amybronk/woordklok/README.md

# woordklok
het is een woordklok
 de dezine files moeten nog geupload worden 
 
