amybronk/woordklok/dezine file/mainprint V1.2/untitled/3d/UA78M33CDCYG3.step

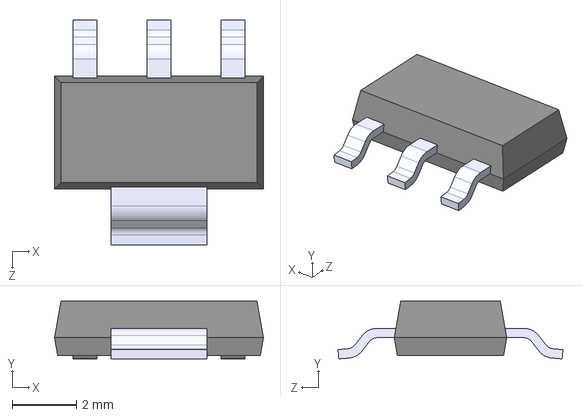
[picture p1: CAD file, 2025-05-20, an earlier design]
dezine file/mainprint V1.2/untitled/3d/UA78M33CDCYG3.step
6.50 x 1.80 x 7.00 mm
