amybronk/woordklok/dezine file/mainprint V1.2/untitled/3d/DS1302Z_.step

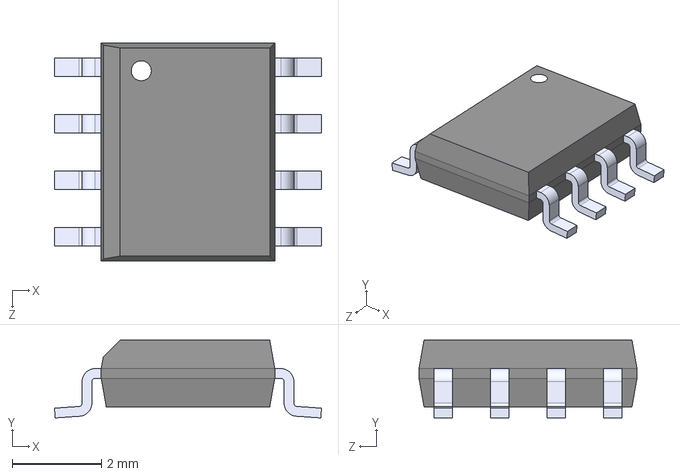
[picture p2: CAD file, 2025-05-20, an earlier design]
dezine file/mainprint V1.2/untitled/3d/DS1302Z_.step
6.00 x 1.75 x 4.90 mm
