amybronk/woordklok/dezine file/mainprint V1.2/untitled/3d/ESP32-S3-WROOM-1-N16R8.step

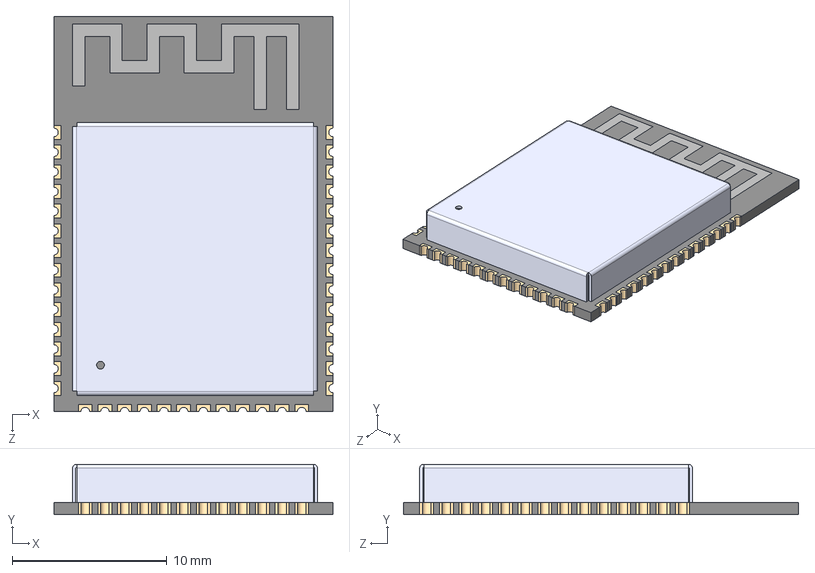
[picture p3: CAD file, 2025-05-20, an earlier design]
dezine file/mainprint V1.2/untitled/3d/ESP32-S3-WROOM-1-N16R8.step
18.0 x 3.25 x 25.5 mm
