amybronk/woordklok/dezine file/mainprint V1.2/untitled/3d/0805res.STEP

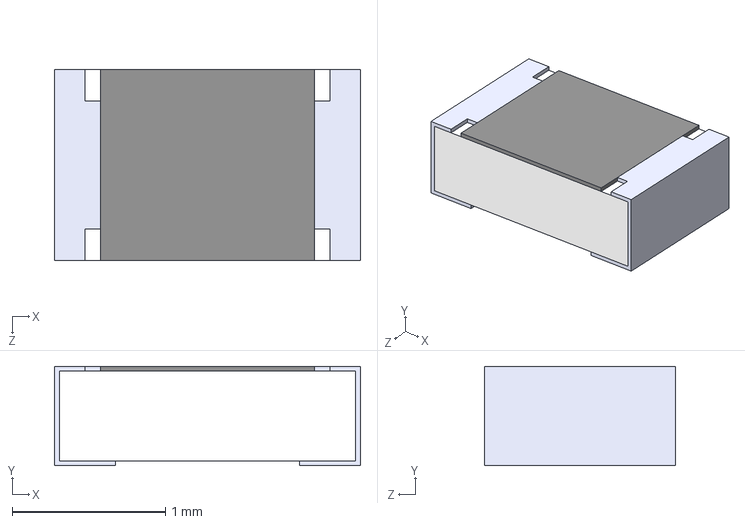
[picture p4: CAD file, 2025-05-20, an earlier design]
dezine file/mainprint V1.2/untitled/3d/0805res.STEP
2.00 x 0.65 x 1.25 mm
