amybronk/woordklok/dezine file/mainprint V1.2/untitled/3d/TS02-66-95-BK-260-LCR-D.step

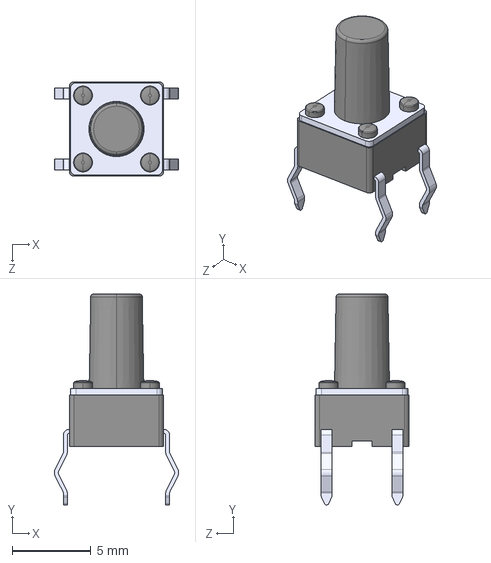
[picture p5: CAD file, 2025-05-20, an earlier design]
dezine file/mainprint V1.2/untitled/3d/TS02-66-95-BK-260-LCR-D.step
7.90 x 13.4 x 6.00 mm
