amybronk/woordklok/dezine file/mainprint V1.2/untitled/3d/CSP-USC16-TR.step

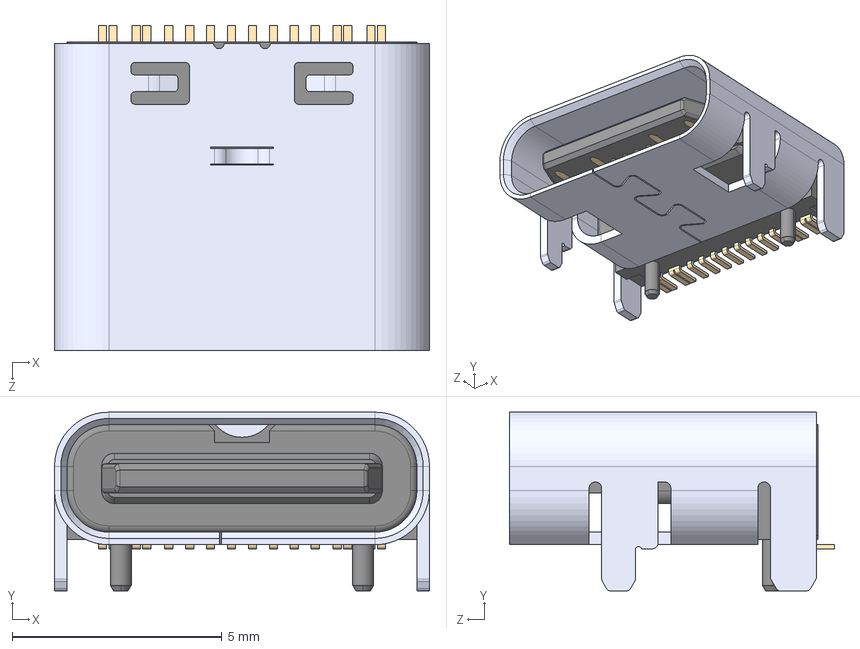
[picture p6: CAD file, 2025-05-20, an earlier design]
dezine file/mainprint V1.2/untitled/3d/CSP-USC16-TR.step
8.94 x 4.26 x 7.75 mm
