amybronk/woordklok/dezine file/mainprint V1.2/untitled/3d/0805cap.STEP

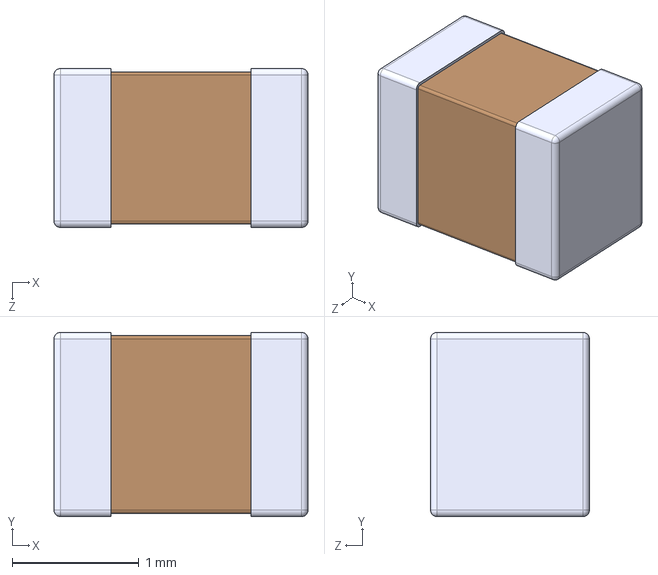
[picture p7: CAD file, 2025-05-20, an earlier design]
dezine file/mainprint V1.2/untitled/3d/0805cap.STEP
2.00 x 1.45 x 1.25 mm
