amybronk/woordklok/dezine file/mainprint V1.2/untitled/3d/WS2812B.step

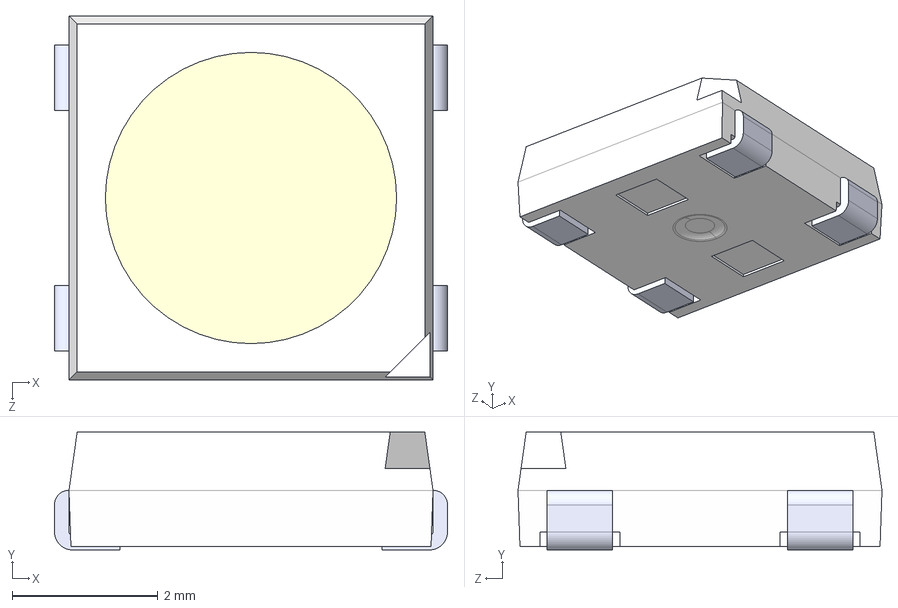
[picture p8: CAD file, 2025-05-20, an earlier design]
dezine file/mainprint V1.2/untitled/3d/WS2812B.step
5.40 x 1.62 x 5.00 mm
