amybronk/woordklok/dezine file/mainprint V1.2/untitled/3d/BHSD-2032-SM--3DModel-STEP-269445.STEP

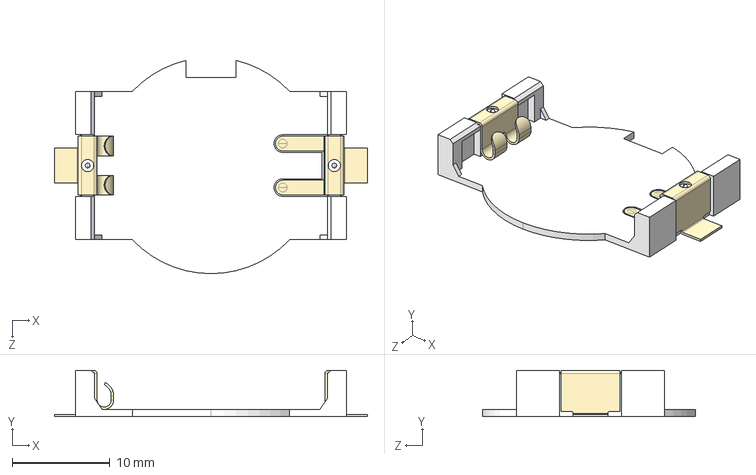
[picture p9: CAD file, 2025-05-20, an earlier design]
dezine file/mainprint V1.2/untitled/3d/BHSD-2032-SM--3DModel-STEP-269445.STEP
32.0 x 4.75 x 21.8 mm
