amybronk/woordklok/dezine file/mainprint V1.2/untitled/3d/10067847-011RLF.step

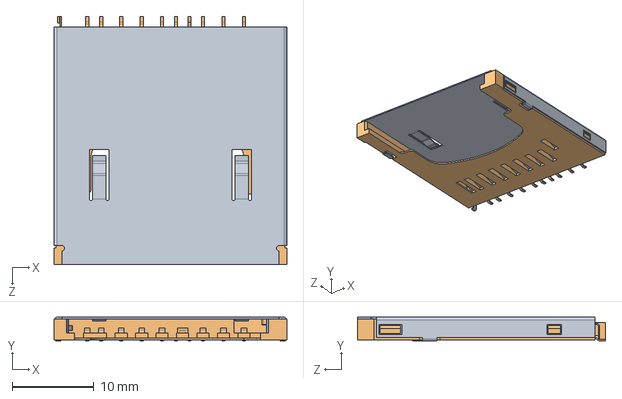
[picture p10: CAD file, 2025-05-20, an earlier design]
dezine file/mainprint V1.2/untitled/3d/10067847-011RLF.step
28.4 x 2.90 x 30.3 mm
PRT0003^ASM0003_ASM_ASM0002_ASM_10067847-011RLF--3DModel-STEP-533217(2)_10067847-011RLF--3DModel-STEP-533217
PRT0005^ASM0002_ASM_10067847-011RLF--3DModel-STEP-533217(2)_10067847-011RLF--3DModel-STEP-533217
