amybronk/woordklok/(list of files, cad)

Other CAD files:
dezine file/behuizing/Behuizing klok V5.dwg
