amybronk/woordklok/dezine file/behuizing/Samenstellingstekening divider.pdf

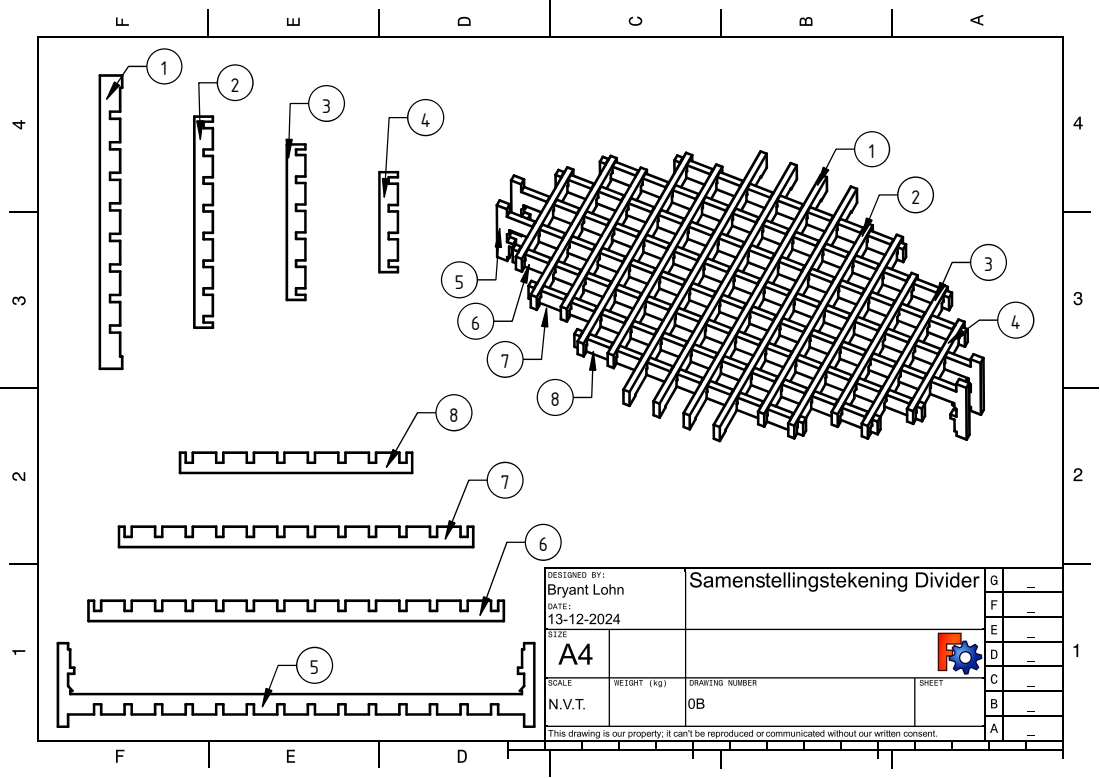
[picture p11: page 1]
