amybronk/woordklok/dezine file/behuizing/Samenstellingstekening klok.pdf

1254 3

11

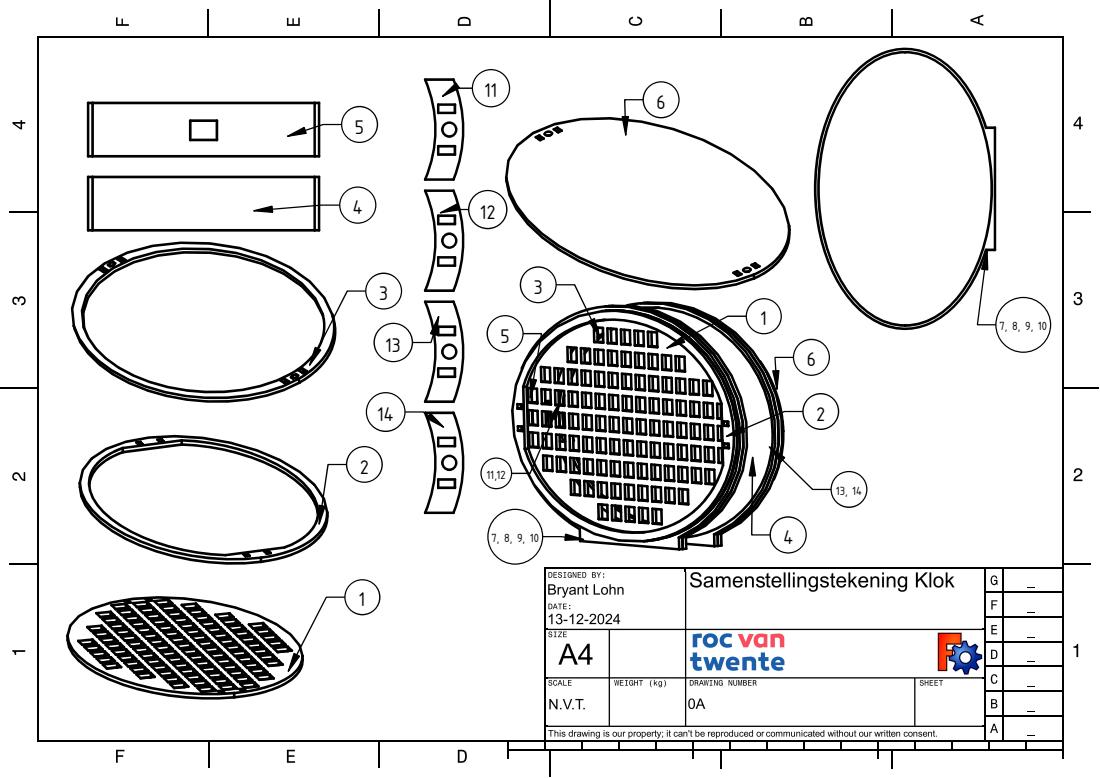
[picture p12: page 1]
