amybronk/woordklok/dezine file/mainprint V2/woordklok v2/woordklok v2.kicad_pcb

## KiCad design dezine file/mainprint V2/woordklok v2/woordklok v2.kicad_pcb (2025-05-20)

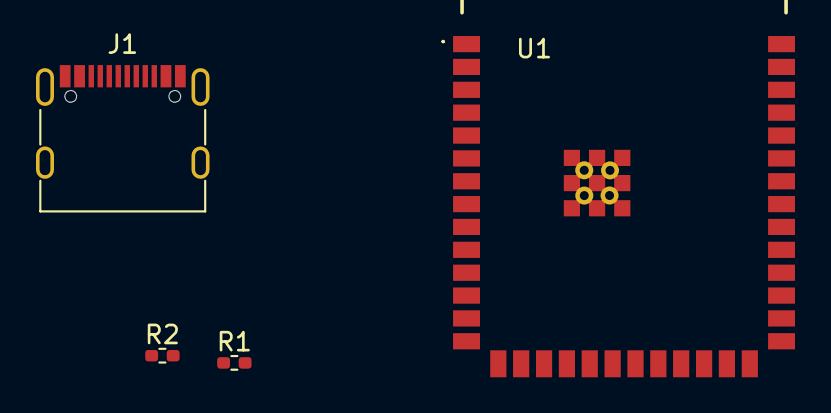
[picture p13: board woordklok v2.kicad_pcb from above]

Board: 2 copper layers, 4 parts (0 on the bottom side), 6 nets, no tracks yet.

Parts:
J1: USB_C_Receptacle_USB2.0_16P; USB_C_Receptacle_G-Switch_GT-USB-7010ASV
R1, R2: 22R; R_0402_1005Metric_Pad0.72x0.64mm_HandSolder
U1: esp32-s3-wroom; ESP32S3WROOM1

Connections:
/USB1.D+: R2.1, U1.14 (IO20)
/USB1.D-: R1.1, U1.13 (IO19)
GND: J1.A1 (GND), J1.A12 (GND), J1.B1 (GND), J1.B12 (GND), J1.S1 (SHIELD), U1.1 (GND), U1.40 (GND), U1.41 (GND)
unnamed: J1.A4 (VBUS), J1.A9 (VBUS), J1.B4 (VBUS), J1.B9 (VBUS)
USB_N: J1.A7 (D-), J1.B7 (D-), R1.2
USB_P: J1.A6 (D+), J1.B6 (D+), R2.2
