amybronk/woordklok/dezine file/mainprint V1.2/untitled/untitled.kicad_pcb

## KiCad design dezine file/mainprint V1.2/untitled/untitled.kicad_pcb (2025-05-20, an earlier design)

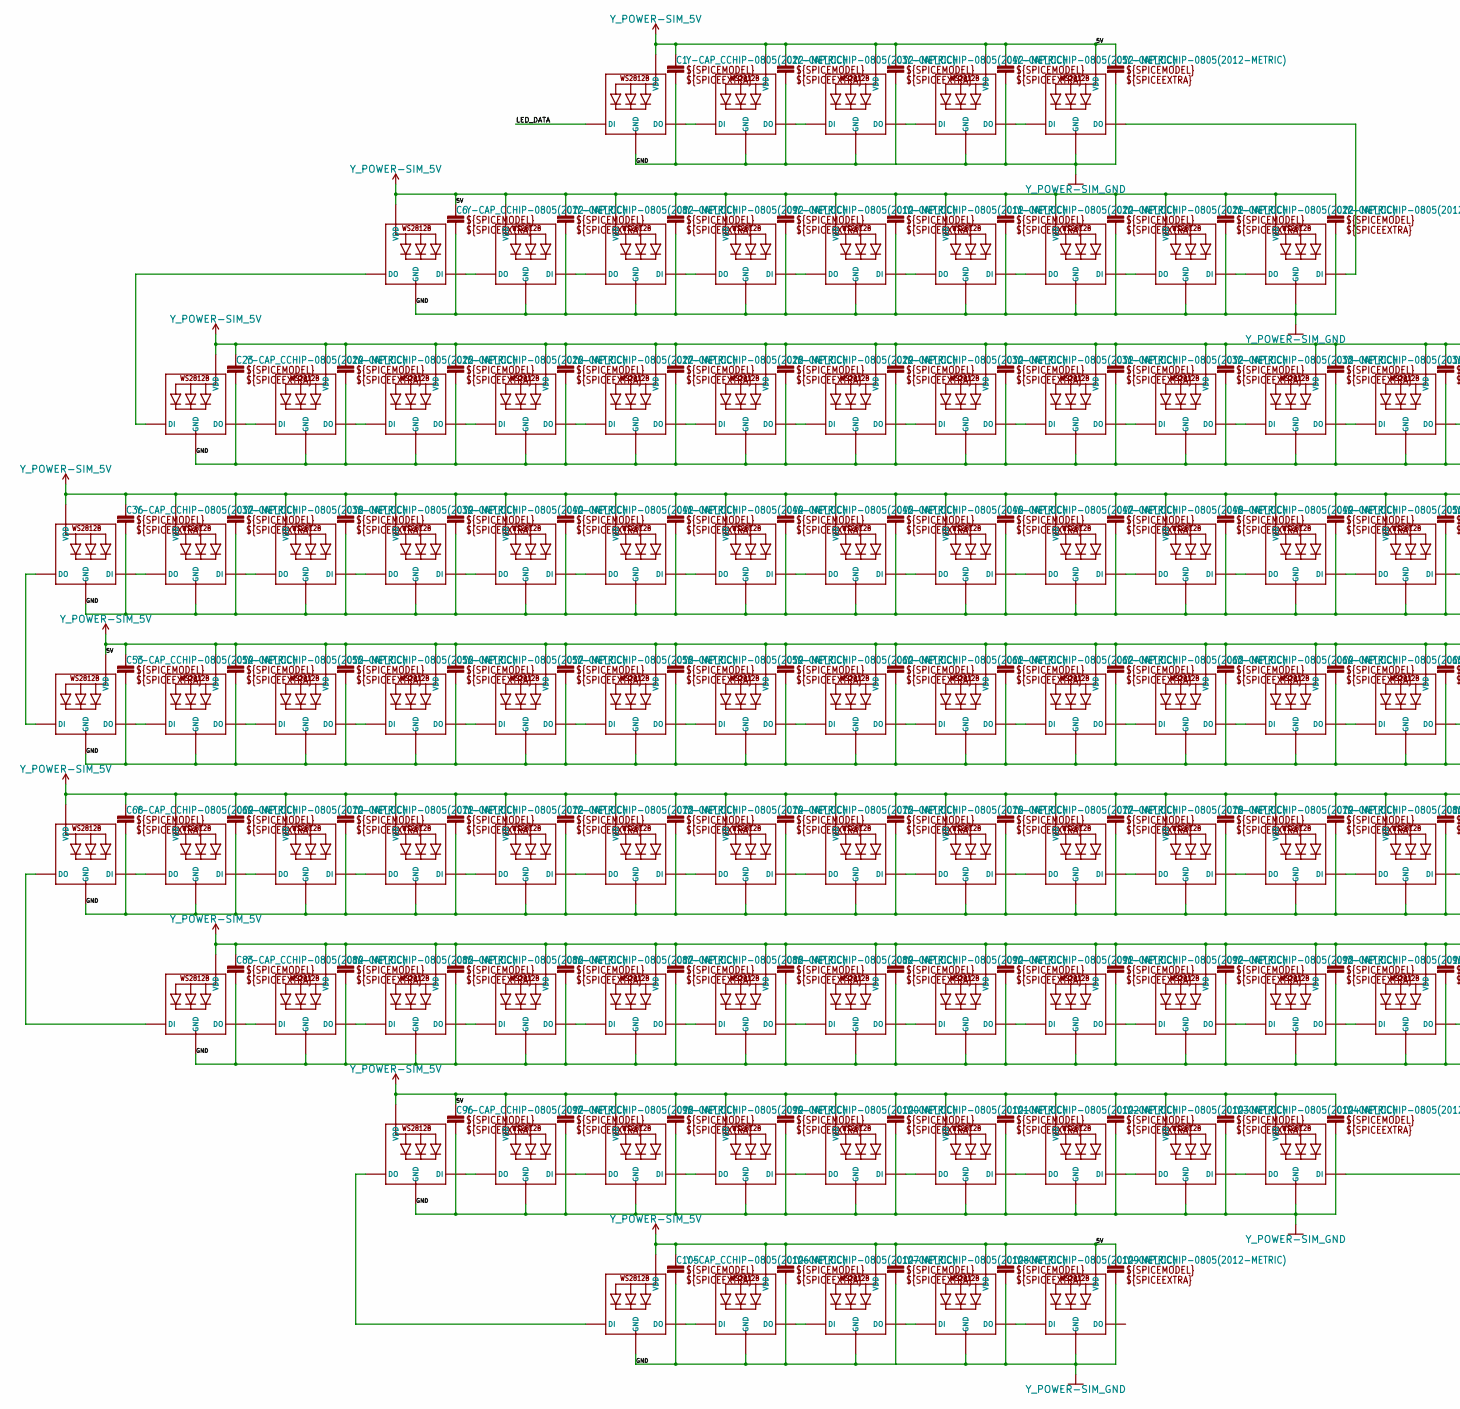
[picture p14: schematic untitled.kicad_sch, part in row 1, column 1]

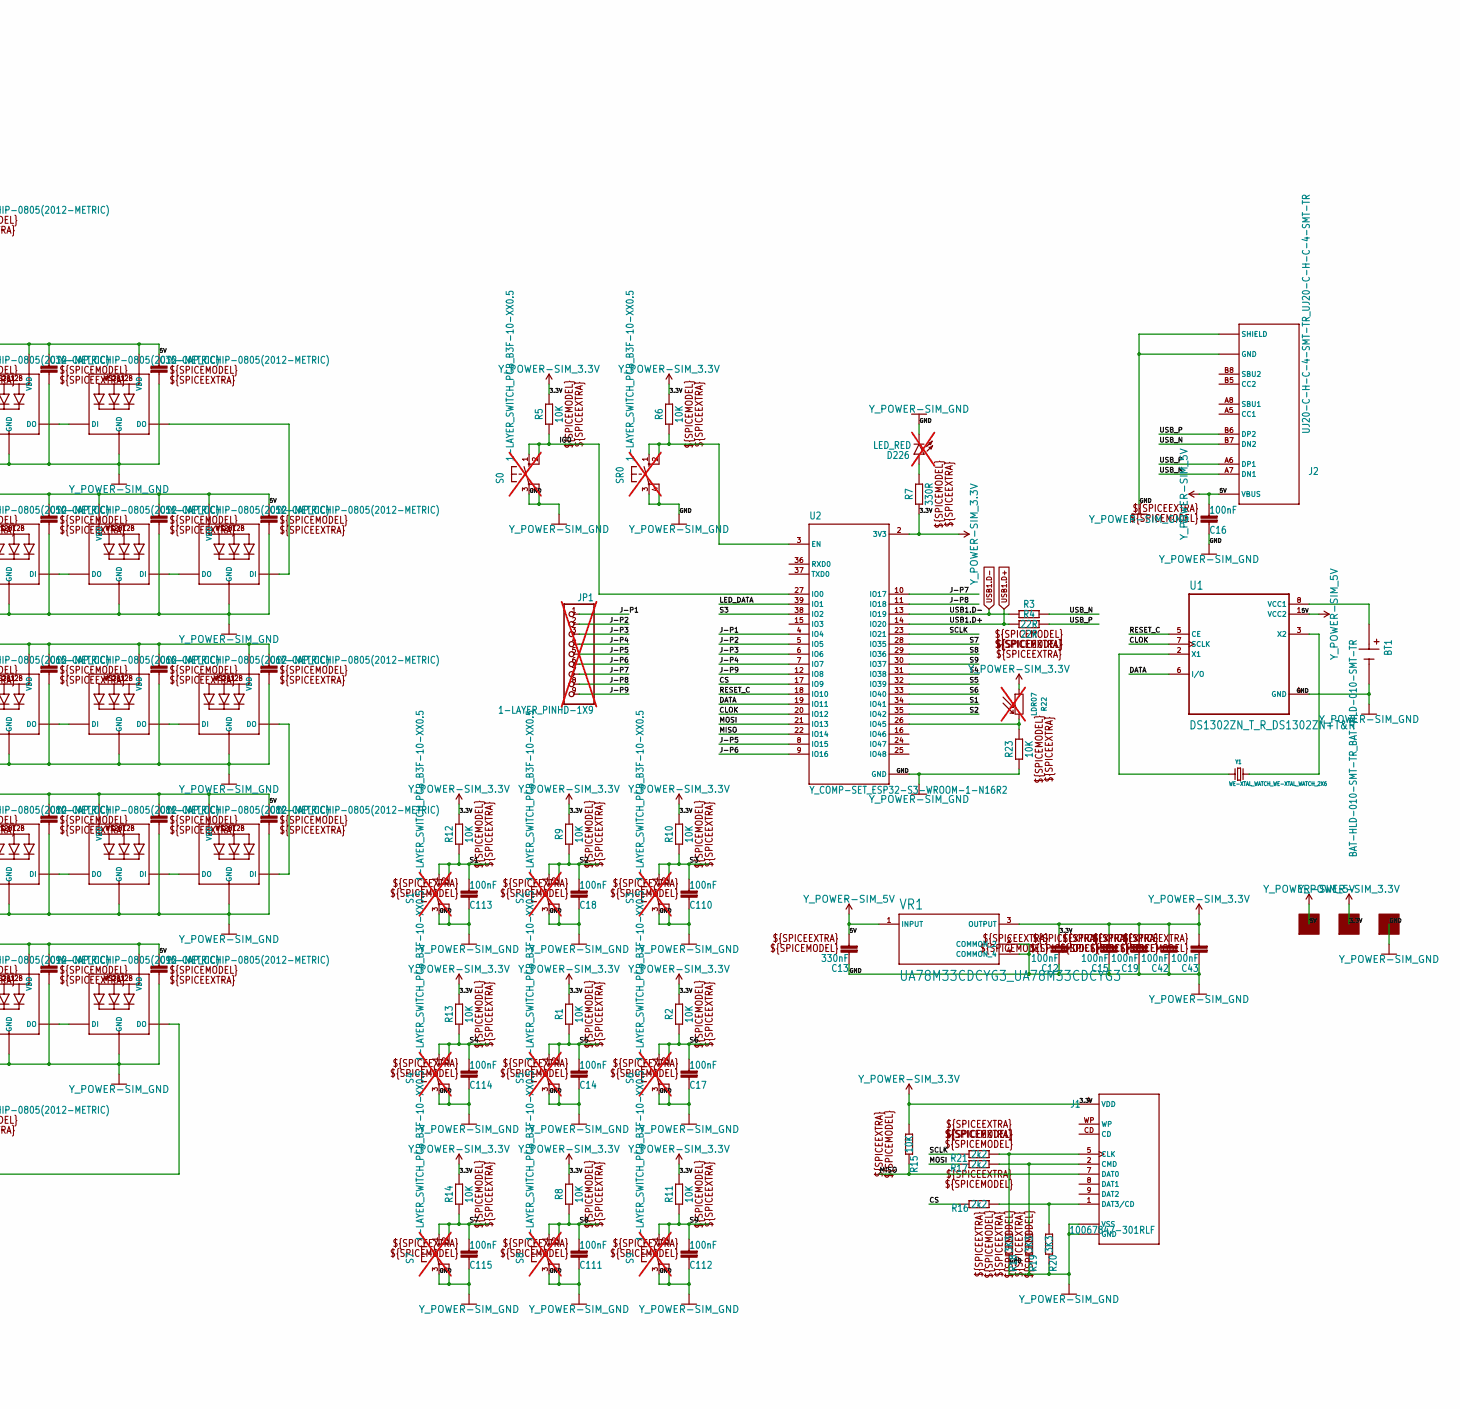
[picture p15: schematic untitled.kicad_sch, part in row 1, column 2]

Parts:
BT1: BAT-HLD-010-SMT-TR_BAT-HLD-010-SMT-TR; BAT-HLD-010-SMT-TR_BAT_BAT-HLD-010-SMT-TR
C1, C2, C3, C4, C5, C6, C7, C8, C9, C10, C11, C20, C21, C22, C23, C24, C25, C26, C27, C28, C29, C30, C31, C32, C33, C34, C35, C36, C37, C38, C39, C40, C41, C44, C45, C46, C47, C48, C49, C50, C51, C52, C53, C54, C55, C56, C57, C58, C59, C60, C61, C62, C63, C64, C65, C66, C67, C68, C69, C70, C71, C72, C73, C74, C75, C76, C77, C78, C79, C80, C81, C82, C83, C84, C85, C86, C87, C88, C89, C90, C91, C92, C93, C94, C95, C96, C97, C98, C99, C100, C101, C102, C103, C104, C105, C106, C107, C108, C109: Y-CAP_CCHIP-0805(2012-METRIC); Y-CAP_CAPC2012X110
C12, C14, C15, C16, C17, C18, C19, C42, C43, C110, C111, C112, C113, C114, C115: 100nF; Y-CAP_CAPC2012X110
C13: 330nF; Y-CAP_CAPC2012X110
D226: LED_RED; 1-LAYER_LED5MM_R-ROC; not fitted
J1: 10067847-301RLF; AMPHENOL_10067847-301RLF
J2: UJ20-C-H-C-4-SMT-TR_UJ20-C-H-C-4-SMT-TR; UJ20-C-H-C-4-SMT-TR_CUI_UJ20-C-H-C-4-SMT-TR
JP1: 1-LAYER_PINHD-1X9; 1-LAYER_1X09; not fitted
LED1, LED2, LED3, LED4, LED5, LED6, LED7, LED8, LED9, LED10, LED11, LED12, LED13, LED14, LED15, LED16, LED17, LED18, LED19, LED20, LED21, LED22, LED23, LED24, LED25, LED26, LED27, LED28, LED29, LED30, LED31, LED32, LED33, LED34, LED35, LED36, LED37, LED38, LED39, LED40, LED41, LED42, LED43, LED44, LED45, LED46, LED47, LED48, LED49, LED50, LED51, LED52, LED53, LED54, LED55, LED56, LED57, LED58, LED59, LED60, LED61, LED62, LED63, LED64, LED65, LED66, LED67, LED68, LED69, LED70, LED71, LED72, LED73, LED74, LED75, LED76, LED77, LED78, LED79, LED80, LED81, LED82, LED83, LED84, LED85, LED86, LED87, LED88, LED89, LED90, LED91, LED92, LED93, LED94, LED95, LED96, LED97, LED98, LED99: WS2812B_WS2812B_5050N; WS2812B_WS2812B-NARROW
R1, R2, R5, R6, R8, R9, R10, R11, R12, R13, R14, R15, R23: 10K; Y-RES_RESC2012X65
R3, R4: 22R; Y-RES_RESC2012X65
R7: 330R; Y-RES_RESC2012X65
R16, R17, R21: 2k2; Y-RES_RESC2012X65
R18, R19, R20: 3K3; Y-RES_RESC2012X65
R22: LDR07; R_LDR_5.1x4.3mm_P3.4mm_Vertical; not fitted
S0, S1, S2, S3, S4, S5, S6, S7, S8, S9: 1-LAYER_SWITCH_PCB_B3F-10-XX0.5; 1-LAYER_B3F-10XXROC; not fitted
SR0: 1-LAYER_SWITCH_PCB_B3F-10-XX0.5; 1-LAYER_B3F-10XXROC; not fitted
U1: DS1302ZN_T_R_DS1302ZN+T&R; DS1302ZN_T_R_SOIC127P600X175-8N
U2: Y_COMP-SET_ESP32-S3-WROOM-1-N16R2; Y_COMP-SET_XCVR_ESP32-S3-WROOM-1-N16R2
U$1, U$2, U$3: Y_CONECTOR_POGOPAD2; Y_CONECTOR_POGOPAD_50
VR1: UA78M33CDCYG3_UA78M33CDCYG3; UA78M33CDCYG3_VREG_UA78M33CDCYG3
Y1: WE-XTAL_WATCH_WE-XTAL_WATCH_2X6; WE-XTAL_WATCH_WE-XTAL_WATCH-2X6

Connections:
/CLOK: U1.7 (SCLK), U2.20 (IO12)
/CS: R16.2, U2.17 (IO9)
/DATA: U1.6 (I/O), U2.19 (IO11)
/IO0: R5.1, S0.1 (S), S0.2 (S1), U2.27 (IO0)
/J-P1: JP1.1, U2.4 (IO4)
/J-P2: JP1.2, U2.5 (IO5)
/J-P3: JP1.3, U2.6 (IO6)
/J-P4: JP1.4, U2.7 (IO7)
/J-P5: JP1.5, U2.8 (IO15)
/J-P6: JP1.6, U2.9 (IO16)
/J-P7: JP1.7, U2.10 (IO17)
/J-P8: JP1.8, U2.11 (IO18)
/J-P9: JP1.9, U2.12 (IO8)
/LED_DATA: LED1.4-DIN (DI), U2.39 (IO1)
/MISO: J1.7 (DAT0), R15.2, U2.22 (IO14)
/MOSI: R17.2, U2.21 (IO13)
/RESET_C: U1.5 (CE), U2.18 (IO10)
/S1: C113.2, R12.1, S1.1 (S), S1.2 (S1), U2.34 (IO41)
/S2: C18.2, R9.1, S2.1 (S), S2.2 (S1), U2.35 (IO42)
/S3: C110.2, R10.1, S3.1 (S), S3.2 (S1), U2.38 (IO2)
/S4: C114.2, R13.1, S4.1 (S), S4.2 (S1), U2.31 (IO38)
/S5: C14.2, R1.1, S5.1 (S), S5.2 (S1), U2.32 (IO39)
/S6: C17.2, R2.1, S6.1 (S), S6.2 (S1), U2.33 (IO40)
/S7: C115.2, R14.1, S7.1 (S), S7.2 (S1), U2.28 (IO35)
/S8: C111.2, R8.1, S8.1 (S), S8.2 (S1), U2.29 (IO36)
/S9: C112.2, R11.1, S9.1 (S), S9.2 (S1), U2.30 (IO37)
/SCLK: R21.2, U2.23 (IO21)
/USB_N: J2.A7 (DN1), J2.B7 (DN2), R3.2
/USB_P: J2.A6 (DP1), J2.B6 (DP2), R4.2
unnamed: J1.5 (CLK), R18.1, R21.1
unnamed: J1.2 (CMD), R17.1, R19.1
unnamed: J1.1 (DAT3/CD), R16.1, R20.1
unnamed: LED1.2-DOUT (DO), LED2.4-DIN (DI)
unnamed: LED2.2-DOUT (DO), LED3.4-DIN (DI)
unnamed: LED3.2-DOUT (DO), LED4.4-DIN (DI)
unnamed: LED4.2-DOUT (DO), LED5.4-DIN (DI)
unnamed: LED6.4-DIN (DI), LED7.2-DOUT (DO)
unnamed: LED7.4-DIN (DI), LED8.2-DOUT (DO)
unnamed: LED8.4-DIN (DI), LED9.2-DOUT (DO)
unnamed: LED10.4-DIN (DI), LED11.2-DOUT (DO)
unnamed: LED9.4-DIN (DI), LED10.2-DOUT (DO)
unnamed: LED11.4-DIN (DI), LED12.2-DOUT (DO)
unnamed: LED12.4-DIN (DI), LED13.2-DOUT (DO)
unnamed: LED13.4-DIN (DI), LED14.2-DOUT (DO)
unnamed: LED5.2-DOUT (DO), LED14.4-DIN (DI)
unnamed: LED15.4-DIN (DI), LED24.2-DOUT (DO)
unnamed: LED15.2-DOUT (DO), LED26.4-DIN (DI)
unnamed: LED16.4-DIN (DI), LED17.2-DOUT (DO)
unnamed: LED16.2-DOUT (DO), LED27.4-DIN (DI)
unnamed: LED17.4-DIN (DI), LED18.2-DOUT (DO)
unnamed: LED18.4-DIN (DI), LED19.2-DOUT (DO)
unnamed: LED19.4-DIN (DI), LED25.2-DOUT (DO)
unnamed: LED6.2-DOUT (DO), LED20.4-DIN (DI)
unnamed: LED20.2-DOUT (DO), LED21.4-DIN (DI)
unnamed: LED21.2-DOUT (DO), LED22.4-DIN (DI)
unnamed: LED22.2-DOUT (DO), LED23.4-DIN (DI)
unnamed: LED23.2-DOUT (DO), LED24.4-DIN (DI)
unnamed: LED25.4-DIN (DI), LED45.2-DOUT (DO)
unnamed: LED26.2-DOUT (DO), LED32.4-DIN (DI)
unnamed: LED27.2-DOUT (DO), LED28.4-DIN (DI)
unnamed: LED28.2-DOUT (DO), LED29.4-DIN (DI)
unnamed: LED29.2-DOUT (DO), LED30.4-DIN (DI)
unnamed: LED30.2-DOUT (DO), LED31.4-DIN (DI)
unnamed: LED31.2-DOUT (DO), LED50.4-DIN (DI)
unnamed: LED32.2-DOUT (DO), LED38.4-DIN (DI)
unnamed: LED33.4-DIN (DI), LED34.2-DOUT (DO)
unnamed: LED33.2-DOUT (DO), LED73.4-DIN (DI)
unnamed: LED34.4-DIN (DI), LED35.2-DOUT (DO)
unnamed: LED35.4-DIN (DI), LED36.2-DOUT (DO)
unnamed: LED36.4-DIN (DI), LED37.2-DOUT (DO)
unnamed: LED37.4-DIN (DI), LED39.2-DOUT (DO)
unnamed: LED38.2-DOUT (DO), LED44.4-DIN (DI)
unnamed: LED39.4-DIN (DI), LED40.2-DOUT (DO)
unnamed: LED40.4-DIN (DI), LED41.2-DOUT (DO)
unnamed: LED41.4-DIN (DI), LED42.2-DOUT (DO)
unnamed: LED42.4-DIN (DI), LED43.2-DOUT (DO)
unnamed: LED43.4-DIN (DI), LED58.2-DOUT (DO)
unnamed: LED44.2-DOUT (DO), LED55.4-DIN (DI)
unnamed: LED45.4-DIN (DI), LED46.2-DOUT (DO)
unnamed: LED46.4-DIN (DI), LED47.2-DOUT (DO)
unnamed: LED47.4-DIN (DI), LED48.2-DOUT (DO)
unnamed: LED48.4-DIN (DI), LED49.2-DOUT (DO)
unnamed: LED49.4-DIN (DI), LED60.2-DOUT (DO)
unnamed: LED50.2-DOUT (DO), LED51.4-DIN (DI)
unnamed: LED51.2-DOUT (DO), LED52.4-DIN (DI)
unnamed: LED52.2-DOUT (DO), LED53.4-DIN (DI)
unnamed: LED53.2-DOUT (DO), LED54.4-DIN (DI)
unnamed: LED54.2-DOUT (DO), LED65.4-DIN (DI)
unnamed: LED55.2-DOUT (DO), LED56.4-DIN (DI)
unnamed: LED56.2-DOUT (DO), LED57.4-DIN (DI)
unnamed: LED57.2-DOUT (DO), LED69.4-DIN (DI)
unnamed: LED58.4-DIN (DI), LED59.2-DOUT (DO)
unnamed: LED59.4-DIN (DI), LED63.2-DOUT (DO)
unnamed: LED60.4-DIN (DI), LED61.2-DOUT (DO)
unnamed: LED61.4-DIN (DI), LED62.2-DOUT (DO)
unnamed: LED62.4-DIN (DI), LED68.2-DOUT (DO)
unnamed: LED63.4-DIN (DI), LED64.2-DOUT (DO)
unnamed: LED64.4-DIN (DI), LED72.2-DOUT (DO)
unnamed: LED65.2-DOUT (DO), LED66.4-DIN (DI)
unnamed: LED66.2-DOUT (DO), LED67.4-DIN (DI)
unnamed: LED67.2-DOUT (DO), LED70.4-DIN (DI)
unnamed: LED68.4-DIN (DI), LED69.2-DOUT (DO)
unnamed: LED70.2-DOUT (DO), LED71.4-DIN (DI)
unnamed: LED71.2-DOUT (DO), LED72.4-DIN (DI)
unnamed: LED73.2-DOUT (DO), LED74.4-DIN (DI)
unnamed: LED74.2-DOUT (DO), LED75.4-DIN (DI)
unnamed: LED75.2-DOUT (DO), LED76.4-DIN (DI)
unnamed: LED76.2-DOUT (DO), LED77.4-DIN (DI)
unnamed: LED77.2-DOUT (DO), LED78.4-DIN (DI)
unnamed: LED78.2-DOUT (DO), LED79.4-DIN (DI)
unnamed: LED79.2-DOUT (DO), LED80.4-DIN (DI)
unnamed: LED80.2-DOUT (DO), LED81.4-DIN (DI)
unnamed: LED81.2-DOUT (DO), LED82.4-DIN (DI)
unnamed: LED82.2-DOUT (DO), LED83.4-DIN (DI)
unnamed: LED83.2-DOUT (DO), LED84.4-DIN (DI)
unnamed: LED84.2-DOUT (DO), LED85.4-DIN (DI)
unnamed: LED85.2-DOUT (DO), LED94.4-DIN (DI)
unnamed: LED86.4-DIN (DI), LED87.2-DOUT (DO)
unnamed: LED86.2-DOUT (DO), LED95.4-DIN (DI)
unnamed: LED87.4-DIN (DI), LED88.2-DOUT (DO)
unnamed: LED88.4-DIN (DI), LED89.2-DOUT (DO)
unnamed: LED89.4-DIN (DI), LED90.2-DOUT (DO)
unnamed: LED90.4-DIN (DI), LED91.2-DOUT (DO)
unnamed: LED91.4-DIN (DI), LED92.2-DOUT (DO)
unnamed: LED92.4-DIN (DI), LED93.2-DOUT (DO)
unnamed: LED93.4-DIN (DI), LED94.2-DOUT (DO)
unnamed: LED95.2-DOUT (DO), LED96.4-DIN (DI)
unnamed: LED96.2-DOUT (DO), LED97.4-DIN (DI)
unnamed: LED97.2-DOUT (DO), LED98.4-DIN (DI)
unnamed: LED98.2-DOUT (DO), LED99.4-DIN (DI)
unnamed: R6.1, SR0.1 (S), SR0.2 (S1), U2.3 (EN)
unnamed: BT1.P, U1.8 (VCC1)
unnamed: U1.2 (X1), Y1.1
unnamed: U1.3 (X2), Y1.2
unnamed: R22.2, R23.2, U2.26 (IO45)
USB1.D+: R4.1, U2.14 (IO20)
USB1.D-: R3.1, U2.13 (IO19)
Y_POWER-SIM_3.3V: C12.2, C15.2, C19.2, C42.2, C43.2, J1.4 (VDD), R1.2, R2.2, R5.2, R6.2, R7.1, R8.2, R9.2, R10.2, R11.2, R12.2, R13.2, R14.2, R15.1, R22.1, U2.2 (3V3), U$1.P$1, VR1.3 (OUTPUT)
Y_POWER-SIM_5V: C1.1, C2.1, C3.1, C4.1, C5.1, C6.1, C7.1, C8.1, C9.1, C10.1, C11.1, C13.2, C16.2, C20.1, C21.1, C22.1, C23.1, C24.1, C25.1, C26.1, C27.1, C28.1, C29.1, C30.1, C31.1, C32.1, C33.1, C34.1, C35.1, C36.1, C37.1, C38.1, C39.1, C40.1, C41.1, C44.1, C45.1, C46.1, C47.1, C48.1, C49.1, C50.1, C51.1, C52.1, C53.1, C54.1, C55.1, C56.1, C57.1, C58.1, C59.1, C60.1, C61.1, C62.1, C63.1, C64.1, C65.1, C66.1, C67.1, C68.1, C69.1, C70.1, C71.1, C72.1, C73.1, C74.1, C75.1, C76.1, C77.1, C78.1, C79.1, C80.1, C81.1, C82.1, C83.1, C84.1, C85.1, C86.1, C87.1, C88.1, C89.1, C90.1, C91.1, C92.1, C93.1, C94.1, C95.1, C96.1, C97.1, C98.1, C99.1, C100.1, C101.1, C102.1, C103.1, C104.1, C105.1, C106.1, C107.1, C108.1, C109.1, J2.A4_B9 (VBUS), J2.A9_B4 (VBUS), LED1.1-VDD (VDD), LED2.1-VDD (VDD), LED3.1-VDD (VDD), LED4.1-VDD (VDD), LED5.1-VDD (VDD), LED6.1-VDD (VDD), LED7.1-VDD (VDD), LED8.1-VDD (VDD), LED9.1-VDD (VDD), LED10.1-VDD (VDD), LED11.1-VDD (VDD), LED12.1-VDD (VDD), LED13.1-VDD (VDD), LED14.1-VDD (VDD), LED15.1-VDD (VDD), LED16.1-VDD (VDD), LED17.1-VDD (VDD), LED18.1-VDD (VDD), LED19.1-VDD (VDD), LED20.1-VDD (VDD), LED21.1-VDD (VDD), LED22.1-VDD (VDD), LED23.1-VDD (VDD), LED24.1-VDD (VDD), LED25.1-VDD (VDD), LED26.1-VDD (VDD), LED27.1-VDD (VDD), LED28.1-VDD (VDD), LED29.1-VDD (VDD), LED30.1-VDD (VDD), LED31.1-VDD (VDD), LED32.1-VDD (VDD), LED33.1-VDD (VDD), LED34.1-VDD (VDD), LED35.1-VDD (VDD), LED36.1-VDD (VDD), LED37.1-VDD (VDD), LED38.1-VDD (VDD), LED39.1-VDD (VDD), LED40.1-VDD (VDD), LED41.1-VDD (VDD), LED42.1-VDD (VDD), LED43.1-VDD (VDD), LED44.1-VDD (VDD), LED45.1-VDD (VDD), LED46.1-VDD (VDD), LED47.1-VDD (VDD), LED48.1-VDD (VDD), LED49.1-VDD (VDD), LED50.1-VDD (VDD), LED51.1-VDD (VDD), LED52.1-VDD (VDD), LED53.1-VDD (VDD), LED54.1-VDD (VDD), LED55.1-VDD (VDD), LED56.1-VDD (VDD), LED57.1-VDD (VDD), LED58.1-VDD (VDD), LED59.1-VDD (VDD), LED60.1-VDD (VDD), LED61.1-VDD (VDD), LED62.1-VDD (VDD), LED63.1-VDD (VDD), LED64.1-VDD (VDD), LED65.1-VDD (VDD), LED66.1-VDD (VDD), LED67.1-VDD (VDD), LED68.1-VDD (VDD), LED69.1-VDD (VDD), LED70.1-VDD (VDD), LED71.1-VDD (VDD), LED72.1-VDD (VDD), LED73.1-VDD (VDD), LED74.1-VDD (VDD), LED75.1-VDD (VDD), LED76.1-VDD (VDD), LED77.1-VDD (VDD), LED78.1-VDD (VDD), LED79.1-VDD (VDD), LED80.1-VDD (VDD), LED81.1-VDD (VDD), LED82.1-VDD (VDD), LED83.1-VDD (VDD), LED84.1-VDD (VDD), LED85.1-VDD (VDD), LED86.1-VDD (VDD), LED87.1-VDD (VDD), LED88.1-VDD (VDD), LED89.1-VDD (VDD), LED90.1-VDD (VDD), LED91.1-VDD (VDD), LED92.1-VDD (VDD), LED93.1-VDD (VDD), LED94.1-VDD (VDD), LED95.1-VDD (VDD), LED96.1-VDD (VDD), LED97.1-VDD (VDD), LED98.1-VDD (VDD), LED99.1-VDD (VDD), U1.1 (VCC2), U$3.P$1, VR1.1 (INPUT)
Y_POWER-SIM_GND: BT1.N, C1.2, C2.2, C3.2, C4.2, C5.2, C6.2, C7.2, C8.2, C9.2, C10.2, C11.2, C12.1, C13.1, C14.1, C15.1, C16.1, C17.1, C18.1, C19.1, C20.2, C21.2, C22.2, C23.2, C24.2, C25.2, C26.2, C27.2, C28.2, C29.2, C30.2, C31.2, C32.2, C33.2, C34.2, C35.2, C36.2, C37.2, C38.2, C39.2, C40.2, C41.2, C42.1, C43.1, C44.2, C45.2, C46.2, C47.2, C48.2, C49.2, C50.2, C51.2, C52.2, C53.2, C54.2, C55.2, C56.2, C57.2, C58.2, C59.2, C60.2, C61.2, C62.2, C63.2, C64.2, C65.2, C66.2, C67.2, C68.2, C69.2, C70.2, C71.2, C72.2, C73.2, C74.2, C75.2, C76.2, C77.2, C78.2, C79.2, C80.2, C81.2, C82.2, C83.2, C84.2, C85.2, C86.2, C87.2, C88.2, C89.2, C90.2, C91.2, C92.2, C93.2, C94.2, C95.2, C96.2, C97.2, C98.2, C99.2, C100.2, C101.2, C102.2, C103.2, C104.2, C105.2, C106.2, C107.2, C108.2, C109.2, C110.1, C111.1, C112.1, C113.1, C114.1, C115.1, D226.2 (C), J1.3 (VSS), J1.6 (VSS), J1.G1 (GND), J1.G2 (GND), J2.A1_B12 (GND), J2.A12_B1 (GND), J2.SH1 (SHIELD), J2.SH2 (SHIELD), J2.SH3 (SHIELD), J2.SH4 (SHIELD), LED1.3-GND (GND), LED2.3-GND (GND), LED3.3-GND (GND), LED4.3-GND (GND), LED5.3-GND (GND), LED6.3-GND (GND), LED7.3-GND (GND), LED8.3-GND (GND), LED9.3-GND (GND), LED10.3-GND (GND), LED11.3-GND (GND), LED12.3-GND (GND), LED13.3-GND (GND), LED14.3-GND (GND), LED15.3-GND (GND), LED16.3-GND (GND), LED17.3-GND (GND), LED18.3-GND (GND), LED19.3-GND (GND), LED20.3-GND (GND), LED21.3-GND (GND), LED22.3-GND (GND), LED23.3-GND (GND), LED24.3-GND (GND), LED25.3-GND (GND), LED26.3-GND (GND), LED27.3-GND (GND), LED28.3-GND (GND), LED29.3-GND (GND), LED30.3-GND (GND), LED31.3-GND (GND), LED32.3-GND (GND), LED33.3-GND (GND), LED34.3-GND (GND), LED35.3-GND (GND), LED36.3-GND (GND), LED37.3-GND (GND), LED38.3-GND (GND), LED39.3-GND (GND), LED40.3-GND (GND), LED41.3-GND (GND), LED42.3-GND (GND), LED43.3-GND (GND), LED44.3-GND (GND), LED45.3-GND (GND), LED46.3-GND (GND), LED47.3-GND (GND), LED48.3-GND (GND), LED49.3-GND (GND), LED50.3-GND (GND), LED51.3-GND (GND), LED52.3-GND (GND), LED53.3-GND (GND), LED54.3-GND (GND), LED55.3-GND (GND), LED56.3-GND (GND), LED57.3-GND (GND), LED58.3-GND (GND), LED59.3-GND (GND), LED60.3-GND (GND), LED61.3-GND (GND), LED62.3-GND (GND), LED63.3-GND (GND), LED64.3-GND (GND), LED65.3-GND (GND), LED66.3-GND (GND), LED67.3-GND (GND), LED68.3-GND (GND), LED69.3-GND (GND), LED70.3-GND (GND), LED71.3-GND (GND), LED72.3-GND (GND), LED73.3-GND (GND), LED74.3-GND (GND), LED75.3-GND (GND), LED76.3-GND (GND), LED77.3-GND (GND), LED78.3-GND (GND), LED79.3-GND (GND), LED80.3-GND (GND), LED81.3-GND (GND), LED82.3-GND (GND), LED83.3-GND (GND), LED84.3-GND (GND), LED85.3-GND (GND), LED86.3-GND (GND), LED87.3-GND (GND), LED88.3-GND (GND), LED89.3-GND (GND), LED90.3-GND (GND), LED91.3-GND (GND), LED92.3-GND (GND), LED93.3-GND (GND), LED94.3-GND (GND), LED95.3-GND (GND), LED96.3-GND (GND), LED97.3-GND (GND), LED98.3-GND (GND), LED99.3-GND (GND), R18.2, R19.2, R20.2, R23.1, S0.3, S0.4 (P1), S1.3, S1.4 (P1), S2.3, S2.4 (P1), S3.3, S3.4 (P1), S4.3, S4.4 (P1), S5.3, S5.4 (P1), S6.3, S6.4 (P1), S7.3, S7.4 (P1), S8.3, S8.4 (P1), S9.3, S9.4 (P1), SR0.3, SR0.4 (P1), U1.4 (GND), U2.1 (GND), U2.40 (GND), U2.41_1 (GND), U2.41_2 (GND), U2.41_3 (GND), U2.41_4 (GND), U2.41_5 (GND), U2.41_6 (GND), U2.41_7 (GND), U2.41_8 (GND), U2.41_9 (GND), U2.41_10 (GND), U2.41_11 (GND), U2.41_12 (GND), U2.41_13 (GND), U2.41_14 (GND), U2.41_15 (GND), U2.41_16 (GND), U2.41_17 (GND), U2.41_18 (GND), U2.41_19 (GND), U2.41_20 (GND), U2.41_21 (GND), U$2.P$1, VR1.2 (COMMON_2), VR1.4 (COMMON_4)

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
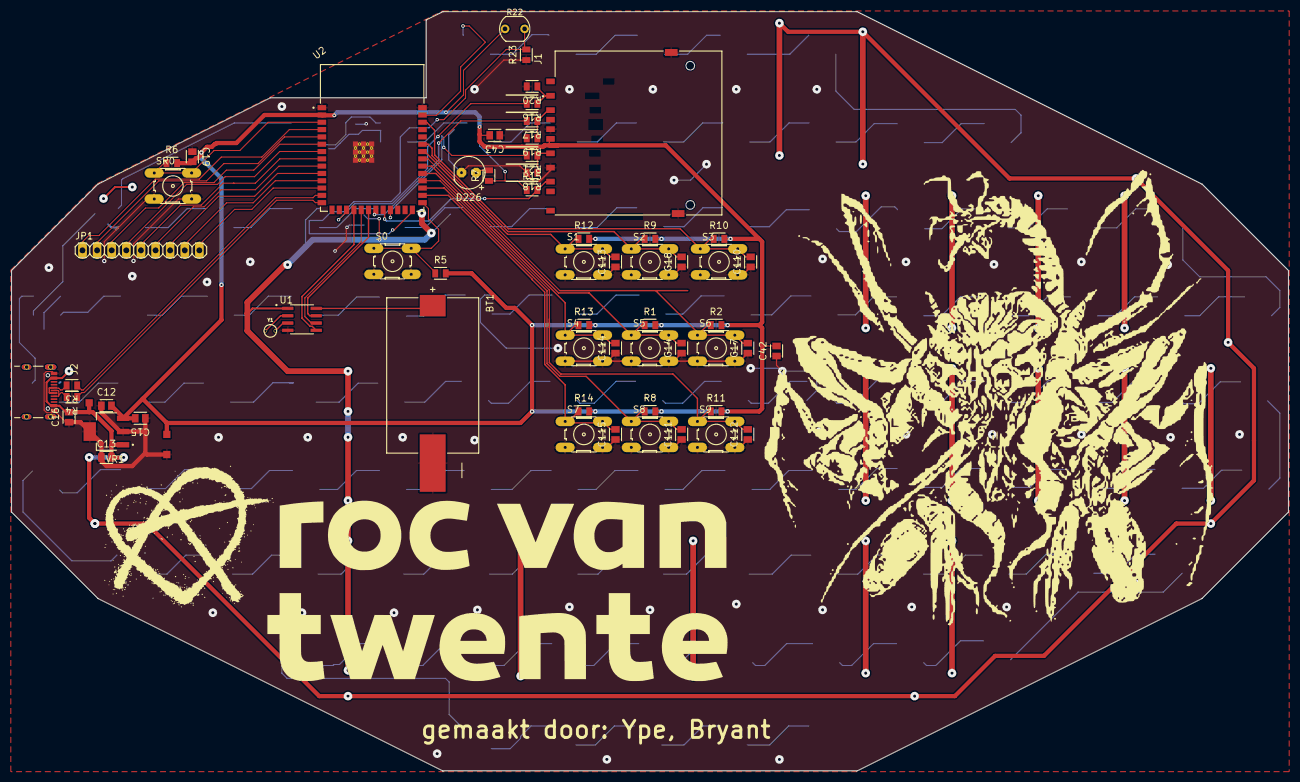
[picture p16: board untitled.kicad_pcb from above]

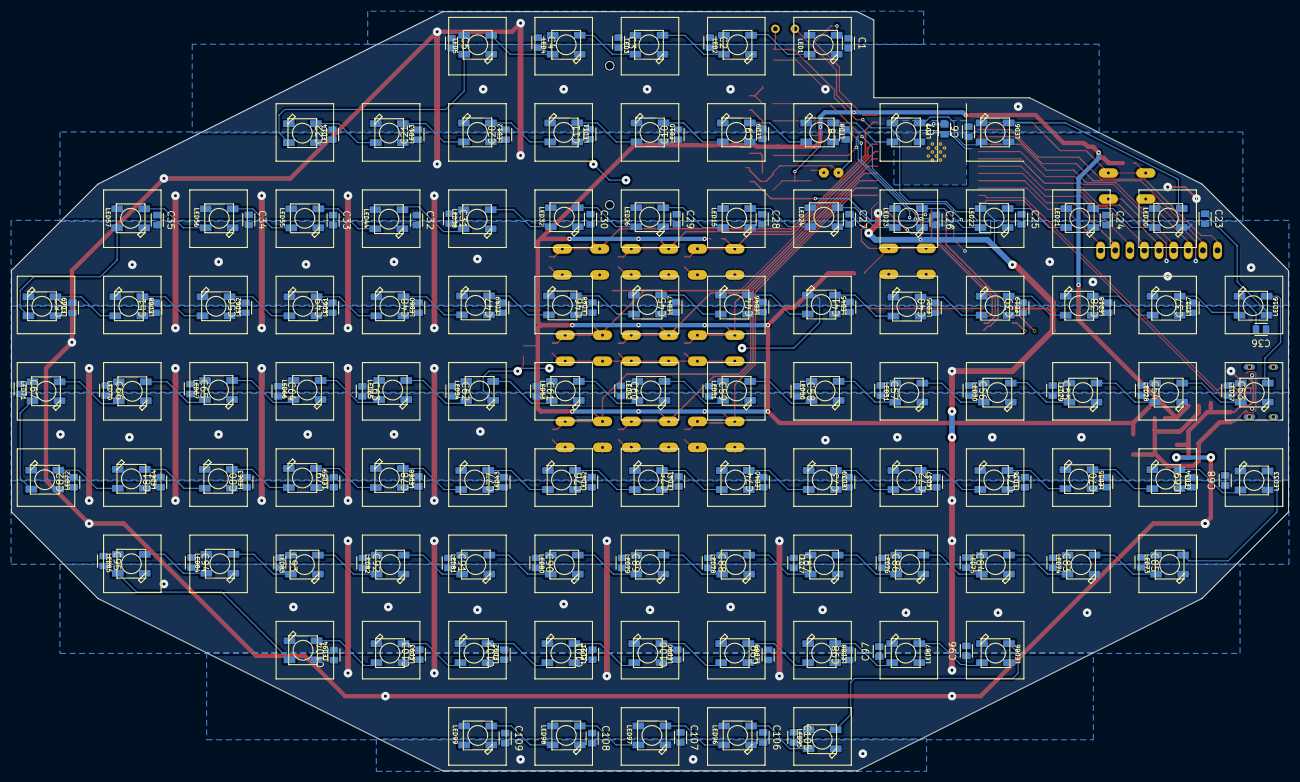
[picture p17: board untitled.kicad_pcb from below]

Board: 2 copper layers, 222.0 x 132.0 mm, 260 parts (198 on the bottom side), 140 nets.
